siposroland/Libella-for-STM32-Nucleo-accelerometer-display-/mlab_pictures/61845658_2670586862955923_3476932603439742976_n.jpg

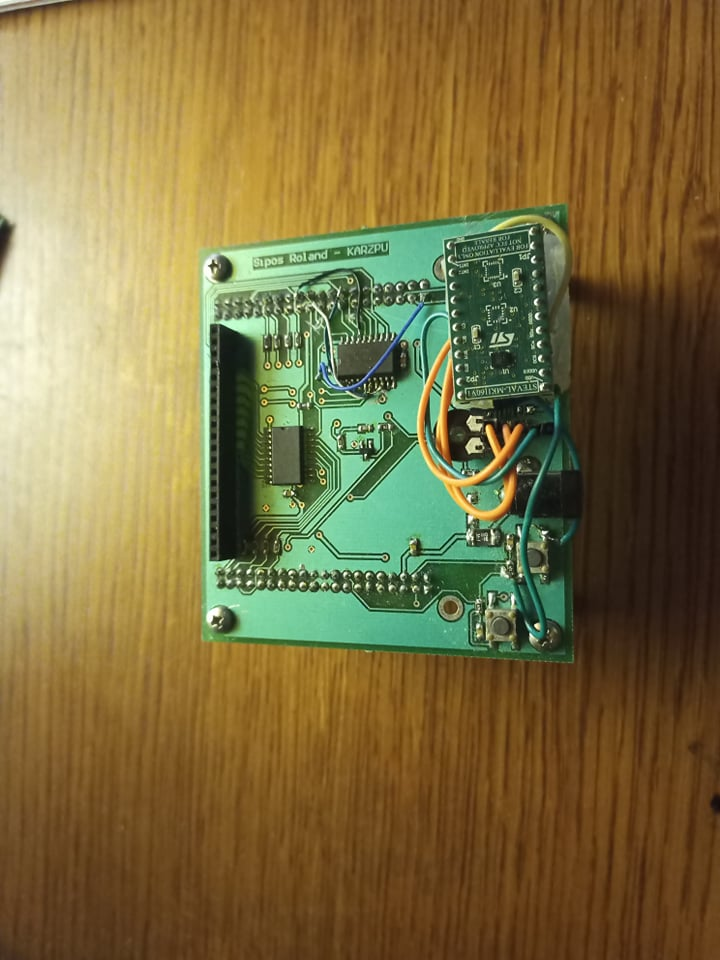
mlab_pictures/61845658_2670586862955923_3476932603439742976_n.jpg
