siposroland/Libella-for-STM32-Nucleo-accelerometer-display-/mlab_pictures/61953386_671046960015293_3710977298522963968_n.jpg

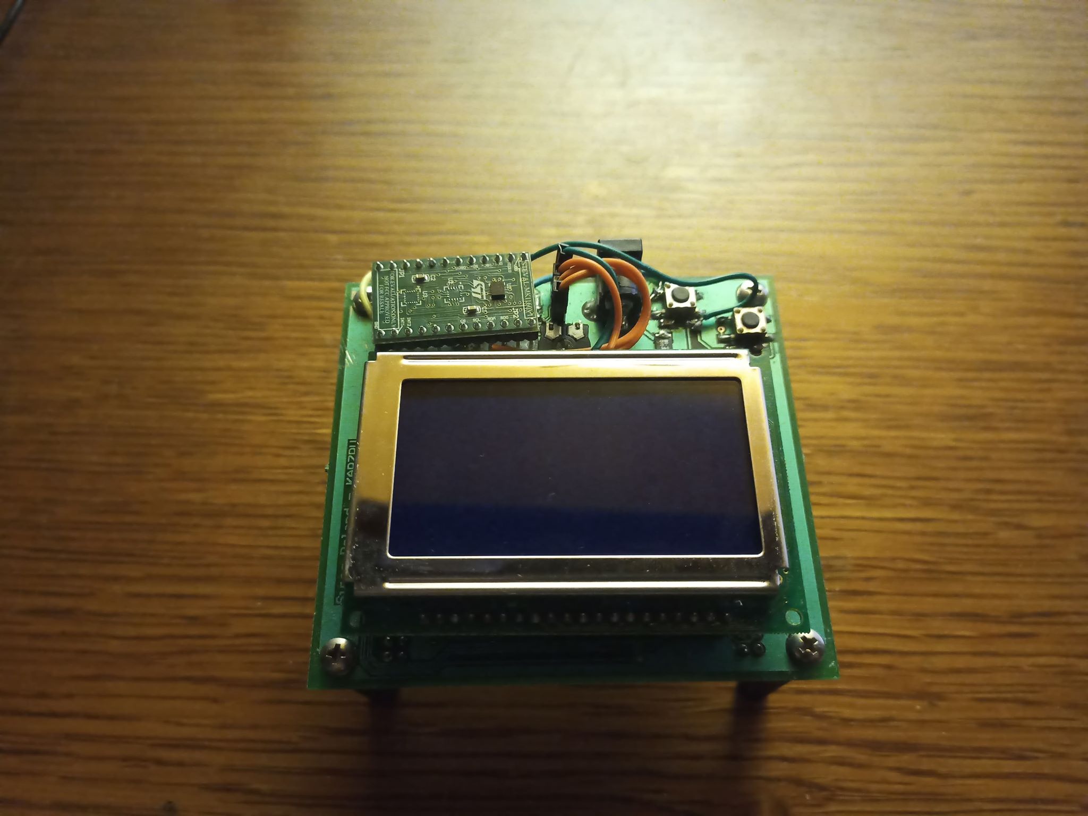
mlab_pictures/61953386_671046960015293_3710977298522963968_n.jpg
