siposroland/Libella-for-STM32-Nucleo-accelerometer-display-/README.md

Libella for STM32 Nucleo (accelerometer + display)
