siposroland/Libella-for-STM32-Nucleo-accelerometer-display-/mlab_pictures/62353342_2189077931402666_7726587320157077504_n.jpg

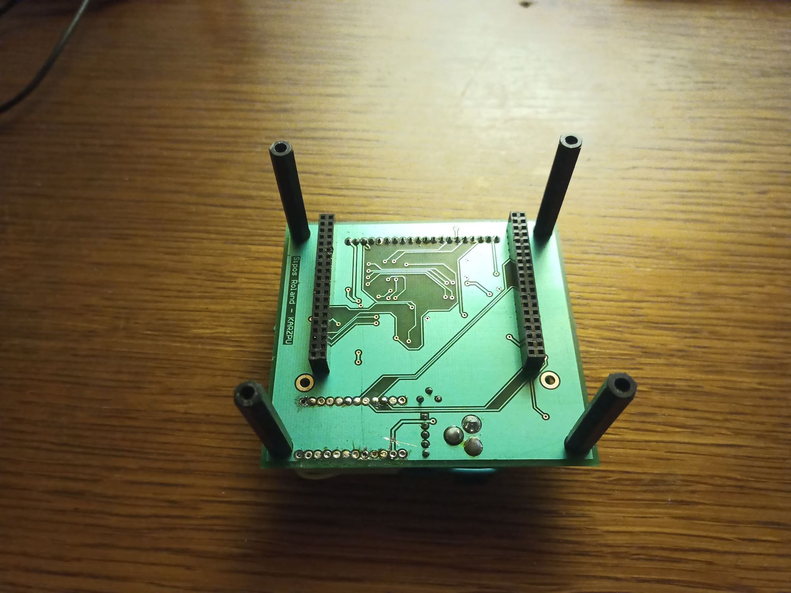
mlab_pictures/62353342_2189077931402666_7726587320157077504_n.jpg
