siposroland/Libella-for-STM32-Nucleo-accelerometer-display-/mlab_hazi_altium/hazi_kiindulas/BOM/MLAB_Hazi.xls

Description | Designator | Quantity | Reference | Supplier | ProjectName | Name
1812 Multifuse | F1 | 1 | 44-02-36 | Lomex | MLAB_Hazi.PrjPcb | 1.1A 16V 1812L110/16DR POLYFUSE SMD 1812 (LFS) ˝LF110-16˝
2.xmm DC HEBA25 TÁPFESZÜLTSÉG ALJZAT ZÁRT, NYÁKBA 90° | J1 | 1 | 43-07-67 | Lomex | MLAB_Hazi.PrjPcb | TÁP DC ANYA 5.5/2.1/9.5mm DCS-5521-5
8x Bidirectional bus transciever | U2 | 1 | 87-06-35 | Lomex | MLAB_Hazi.PrjPcb | 74HCT245D Transceiver, 74HCT245
8xBuffer/Line Driver | U3 | 1 | 87-05-95 | Lomex | MLAB_Hazi.PrjPcb | 74HCT244D-Q100,118 Buffer / Line Driver, 74HCT244
Capacitor | C1, C2, C3, C4, C5, C6 | 12 | 82-10-76 | Lomex | MLAB_Hazi.PrjPcb | 100nF 0805 10% 50V X7R 0805B104K500CT (WAL)
Led Display Module | LCD1 | 1 | 37-00-71 | Lomex | MLAB_Hazi.PrjPcb | 128x 64 DOT LIGHT:LED 64128QCCBW-3LP (DIS) 0.4/DOT
MOSFET, P CH | Q1 | 2 | 86-03-27 | Lomex | MLAB_Hazi.PrjPcb | BSS84 (FAI) P-FET 50V 0.13A Rds<10R SOT-23 ˝13*˝
Potentiometer | RTrim | 1 | 05-07-17 | Lomex | MLAB_Hazi.PrjPcb | 2K20 PT10LV10 (KEN) D=10 TOP ADJ. 5x10
Push button | B1, B2 | 2 | 45-05-42 | Lomex | MLAB_Hazi.PrjPcb | TACT 6x 6 4P SPST 1 FSM2JSMA (TYC) 50mA 12VDC SMD
Resistor | R/oe, RB1, RB2 | 10 | 81-11-11 | Lomex | MLAB_Hazi.PrjPcb | 100K 0805 5% CR-05JL7--100K 0.125W (VIK)
Resistor | R1 | 5 | 81-10-94 | Lomex | MLAB_Hazi.PrjPcb | 3K90 0805 5% CR-05JL7---3K9 0.125W (VIK)
Resistor | Rcr | 5 | 81-10-68 | Lomex | MLAB_Hazi.PrjPcb | 27R0 0805 5% CR-05JL7---27R 0.125W (VIK)
Resistor | Rd0, Rd1, Rd2, Rd3, Rd4, Rd5, Rd6, Rd7, Rload | 20 | 81-10-87 | Lomex | MLAB_Hazi.PrjPcb | 1K00 0805 5% CR-05JL7----1K 0.125W (VIK)
Resistor | Rpmos, Rrst | 5 | 81-10-99 | Lomex | MLAB_Hazi.PrjPcb | 10K0 0805 5% CR-05JL7---10K 0.125W (VIK)
Transient suppressor | D1 | 1 | 96-00-75 | Lomex | MLAB_Hazi.PrjPcb | 6.7V Ubr 400W UNIDIR. 5V Urwm SMAJ5.0A (LFS) DO-214AC (SMA)
Accelerometer | A1 | 1 |  | ST tanszek | MLAB_Hazi.PrjPcb | Accelerometer
ADAPTER | - | 1 | 24-01-65 | Lomex | MLAB_Hazi.PrjPcb | ADAPTER 1200mA 5VDC KAPCSOLÓ ÜZEM 5V 1200mA
LCD connector | - | 1 | 43-00-08 | Lomex | MLAB_Hazi.PrjPcb | HÜVELY 20 P FHSH-2.54-20 (T-T) 1# h=8,5mm AU.
Microcontroller | U1 | 1 | NUCLEO | Tanszék | MLAB_Hazi.PrjPcb | Nucleo F446RE
