siposroland/Libella-for-STM32-Nucleo-accelerometer-display-/mlab_hazi_altium/hallglib.xlsx

Item # | Supplier | Reference | Name | Quantity
1 | Lomex | 44-02-36 | Multifuse | 1
2 | Lomex | 43-07-67 | 2.xmm DC HEBA25 TÁPFESZÜLTSÉG ALJZAT ZÁRT, NYÁKBA 90° | 1
3 | Lomex | 87-06-35 | 8x Bidirectional bus transciever | 1
4 | Lomex | 87-05-95 | 8xBuffer/Line Driver | 1
5 | Lomex | 82-10-76 | Capacitor 100nF | 12
6 | Lomex | 37-00-71 | Led Display Module | 1
7 | Lomex | 86-03-27 | MOSFET, P CH | 2
8 | Lomex | 05-07-17 | Trimmer 10-2200 | 1
9 | Lomex | 45-05-42 | Push button | 2
10 | Lomex | 81-11-11 | Resistor 100K | 10
11 | Lomex | 81-10-94 | Resistor 3K9 | 5
12 | Lomex | 81-10-68 | Resistor 27R | 5
13 | Lomex | 81-10-87 | Resistor 1K | 20
14 | Lomex | 81-10-99 | Resistor 10K | 5
15 | Lomex | 96-00-75 | Transient suppressor | 1
16 | Lomex | 24-01-65 | ADAPTER | 1
17 | Lomex | 43-00-08 | LCD connector | 1
18 | Tanszék | ST-MKI160V1 | Accelerometer | 1
19 | Tanszék | NUCLEO | Microcontroller | 1
