siposroland/Libella-for-STM32-Nucleo-accelerometer-display-/mlab_hazi_altium/mlab_hf_bom_2_karzpu.xlsx

Item # | Supplier | Reference | Name | Quantity
1 | Lomex | 05-06-49 | Trimmer 2kohm | 1
