siposroland/Libella-for-STM32-Nucleo-accelerometer-display-/(list of files, drawings)

Other design files:
mlab_hazi_altium/hallglib.SchLib
mlab_hazi_altium/hazi_kiindulas/Copy of hazi_kiindulas2.PcbDoc
mlab_hazi_altium/hazi_kiindulas/hazi_kiindulas.PcbDoc
mlab_hazi_altium/hazi_kiindulas/MLAB_Hazi.PrjPcb
mlab_hazi_altium/hazi_kiindulas/Nucleo.SchDoc
