siposroland/Libella-for-STM32-Nucleo-accelerometer-display-/mlab_hazi_microc/mlab_hazi.ioc

Mcu.UserName=STM32F446RETx
PA11.Signal=USB_OTG_FS_DM
PA12.Signal=USB_OTG_FS_DP
PA13.GPIO_Label=TMS
PA13.Signal=SYS_JTMS-SWDIO
PA14.GPIO_Label=TCK
PA14.Signal=SYS_JTCK-SWCLK
PA2.GPIO_Label=USART_TX
PA2.Signal=USART2_TX
PA3.GPIO_Label=USART_RX
PA3.Signal=USART2_RX
PA4.GPIO_Label=STM_SPI_CS
PA4.Signal=GPIO_Output
PA5.GPIO_Label=LD2 [Green Led]
PA5.Signal=GPIO_Output
PA6.GPIO_Label=STM_RST
PA6.Signal=GPIO_Output
PB0.GPIO_Label=STM_LCD_1
PB0.Signal=GPIO_Output
PB1.GPIO_Label=STM_DI_NEG
PB1.Signal=GPIO_Output
PB12.GPIO_Label=STM_RW_NEG
PB12.Signal=GPIO_Output
PB13.GPIO_Label=STM_LCD_7
PB13.Signal=GPIO_Output
PB2.GPIO_Label=STM_E
PB2.Signal=GPIO_Output
PB3.GPIO_Label=SWO
PB3.Signal=SYS_JTDO-SWO
PB4.GPIO_Label=STM_LCD_5
PB4.Signal=GPIO_Output
PB5.GPIO_Label=STM_LCD_6
PB5.Signal=GPIO_Output
PB6.Signal=S_TIM4_CH1
PB8.GPIO_Label=STM_INT1
PB8.Signal=GPIO_Input
PB9.GPIO_Label=STM_INT2
PB9.Signal=GPIO_Input
PC0.GPIO_Label=STM_LCD_2
PC0.Signal=GPIO_Output
PC1.Signal=SPI3_MOSI
PC10.Signal=SPI3_SCK
PC11.Signal=SPI3_MISO
PC12.GPIO_Label=STM_BTN1
PC12.Signal=GPIO_Input
PC13.GPIO_Label=B1 [Blue PushButton]
PC13.Signal=GPXTI13
PC14-OSC32_IN.Signal=RCC_OSC32_IN
PC15-OSC32_OUT.Signal=RCC_OSC32_OUT
PC2.GPIO_Label=STM_LCD_0
PC2.Signal=GPIO_Output
PC3.GPIO_Label=STM_LCD_3
PC3.Signal=GPIO_Output
PC4.GPIO_Label=STM_LCD_4
PC4.Signal=GPIO_Output
PC6.GPIO_Label=STM_CS2_NEG
PC6.Signal=GPIO_Output
PC8.GPIO_Label=STM_CS1_NEG
PC8.Signal=GPIO_Output
PC9.GPIO_Label=STM_OE_NEG
PC9.Signal=GPIO_Output
PD2.GPIO_Label=STM_BTN2
PD2.Signal=GPXTI2
PH0-OSC_IN.Signal=RCC_OSC_IN
PH1-OSC_OUT.Signal=RCC_OSC_OUT
