siposroland/Libella-for-STM32-Nucleo-accelerometer-display-/mlab_hazi_microc/Src/bsp_globalfunctions.c

/**
*****************************************************************************
** Kommunikációs mérés - globalfunctions.c
** Egyéb, globális függvények
*****************************************************************************
*/

#include "stm32f4xx.h"
#include "stm32f4xx_hal.h"
#include "bsp_globalfunctions.h"

/* ----------------- Publikus globális változók ----------------- */
/* ----------------- Belso globális változók ----------------- */

// A timer us-onként csökkenti, ha nagyobb, mint 0.
volatile int sys_delay = 0;

TIM_HandleTypeDef Tim4Handle;

/* ----------------- Publikus függvények ----------------- */

/** Globális funkciók inicializálása. */
void GlobalFunctions_Init(void)
{
	/*__TIM4_CLK_ENABLE();

	Tim4Handle.Instance = TIM4;
	Tim4Handle.Init.ClockDivision = TIM_CLOCKDIVISION_DIV1;
	Tim4Handle.Init.CounterMode = TIM_COUNTERMODE_DOWN;
	Tim4Handle.Init.Prescaler = 1;
	Tim4Handle.Init.Period = 168;
	Tim4Handle.State = HAL_TIM_STATE_RESET;
	HAL_TIM_Base_Init(&Tim4Handle);
	HAL_NVIC_SetPriority(TIM4_IRQn, 0, 0);
	HAL_NVIC_EnableIRQ(TIM4_IRQn);
	HAL_TIM_Base_Start_IT(&Tim4Handle);*/
}

/** us számú mikroszekundum várakozás (blokkolva). */
void Sys_DelayUs(int us)
{
	sys_delay = us;
	while(sys_delay);
}

/** ms számú milliszekundum várakozás (blokkolva). */
void Sys_DelayMs(int ms)
{
	sys_delay = ms*1000;
	while(sys_delay);
}

/* ----------------- Megszakításkezelő és callback függvények ----------------- */

void HAL_TIM_PeriodElapsedCallback(TIM_HandleTypeDef *handle)
{
	UNUSED(handle);

	if (sys_delay>0)
	{
		sys_delay--;
	}
}

void TIM4_IRQHandler(void)
{
	//HAL_TIM_IRQHandler(&Tim4Handle);
}
