siposroland/Libella-for-STM32-Nucleo-accelerometer-display-/(commit log)

2019-06-04 Add uC code
    [mlab_hazi Debug.cfg]
2019-06-04 Add SCH and PCB
    [Copy of hazi_kiindulas2.PcbDoc, MLAB_Hazi.PrjPcb, MLAB_Hazi.xls, Nucleo.SchDoc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]
