siposroland/Libella-for-STM32-Nucleo-accelerometer-display-/(notices)

Notices in the files:
mlab_hazi_microc/Src/main.c:
(C) COPYRIGHT STMicroelectronics *****END OF FILE
